fadhil-1911/temp_humi_logger/docs/images/IMG_1106.jpeg

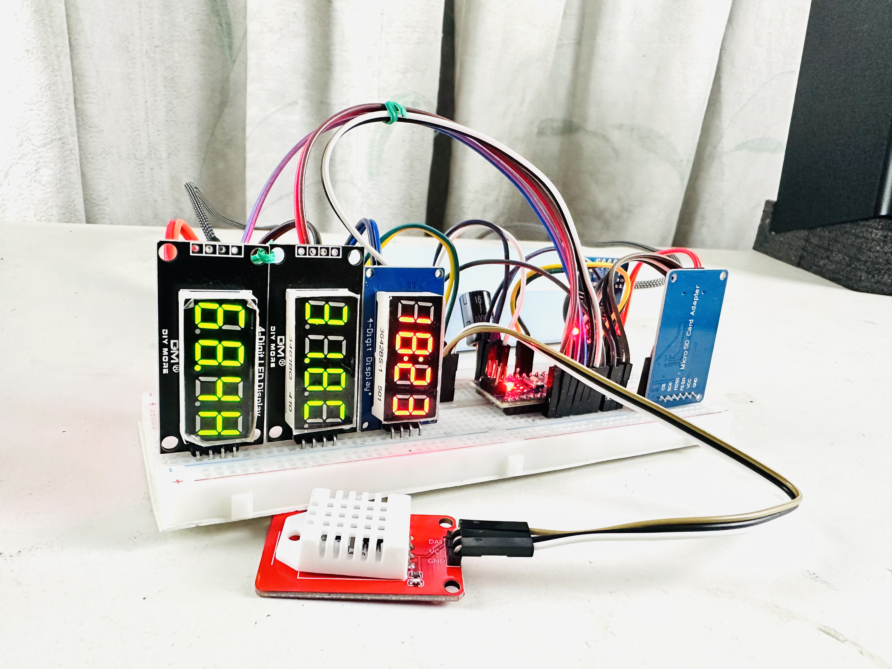
docs/images/IMG_1106.jpeg
