fadhil-1911/temp_humi_logger/docs/images/IMG_1107.jpeg

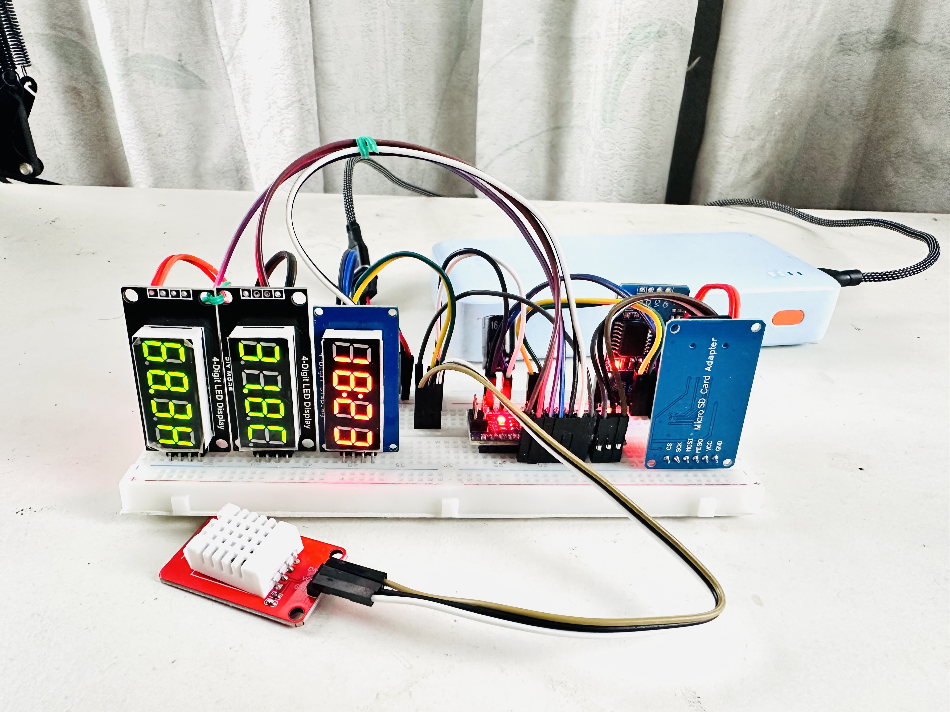
docs/images/IMG_1107.jpeg
