fadhil-1911/temp_humi_logger/docs/images/IMG_1110.jpeg

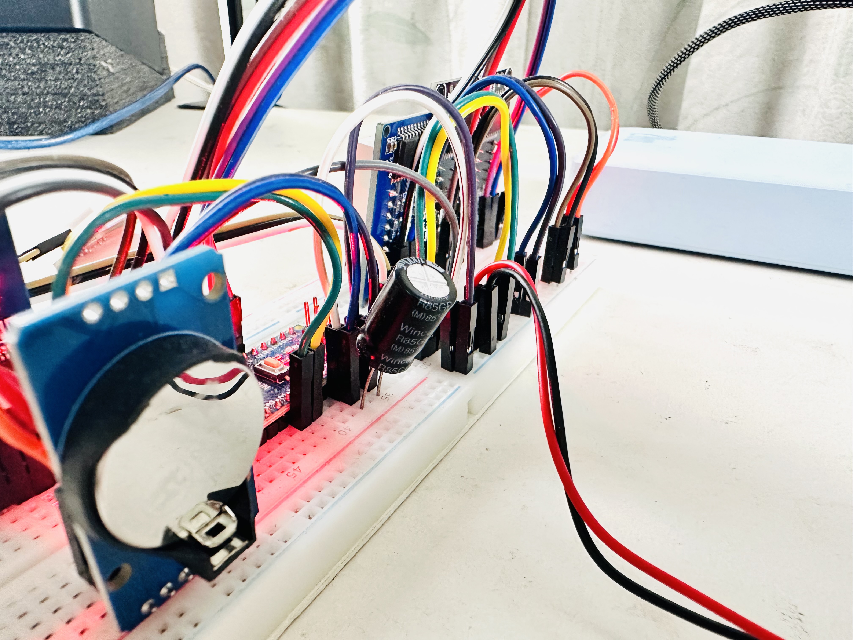
docs/images/IMG_1110.jpeg
