fadhil-1911/temp_humi_logger/docs/images/IMG_1111.jpeg

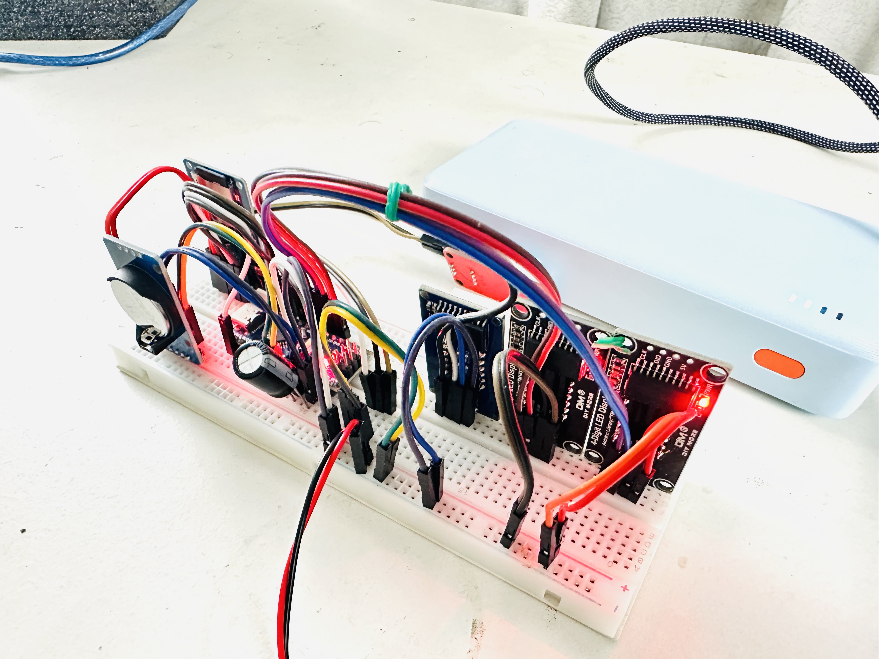
docs/images/IMG_1111.jpeg
