fadhil-1911/temp_humi_logger/docs/images/IMG_1112.jpeg

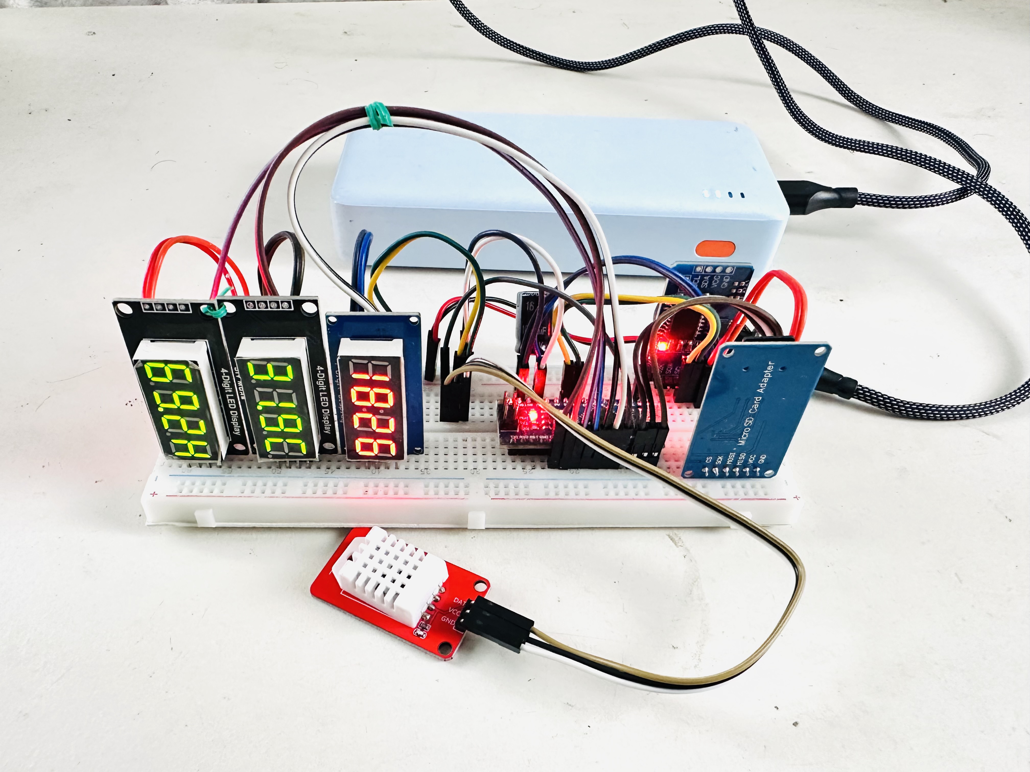
docs/images/IMG_1112.jpeg
