fadhil-1911/temp_humi_logger/temp_humi_logger.ino

//+++++++++++++++++++++++++++++++++++++++++++++++++++++++++
//                  Temp/Humi Logger
//                   Version: 1.3.0
//+++++++++++++++++++++++++++++++++++++++++++++++++++++++++
/*
  Project : Temp/Humi Logger with RTC + DHT22/SHT41 + SD + TM1637
  Version : 1.3.0
  Date    : 2026-08-26

Updates: - Added SHT41 temperature and humidity sensor support. 
- Added compile-time selection between DHT22 and SHT41. 
- Added SHT41 initialization and communication failure detection. 
- Added sensor-specific non-blocking read and retry handling.
- Added SHT41 retry with up to 3 attempts per 2-second sampling slot.. 
- Prevented failed SHT41 transactions from producing stale or invalid readings. 
- Generalized sensor status reporting using SENSOR_OK. 
- Added fail-safe SD handling so sensor, RTC, display, and heartbeat continue 
- operating after an SD logging failure. 
- SD logging is disabled after a card failure until the logger is reset. 
- Optimized constant Serial strings with F() to reduce SRAM usage. 
- Removed 8-second hardware watchdog recovery due to stability issues
*/

//==========================================================
// Libraries
//==========================================================
#include <SmartTM1637.h>  // TM1637 display control
#include <Wire.h>         // I2C communication
#include <RTClib.h>       // DS3231 RTC support
#include <SdFat.h>        // SD card file system

//==========================================================
// Pin Configuration
//==========================================================
#define HEARTBEAT_LED 9  // External heartbeat LED
#define DHT_PIN 8        // DHT22 data pin

#define CLK_PIN_1 2  // TM1637 display 1 clock pin
#define DIO_PIN_1 3  // TM1637 display 1 data pin

#define CLK_PIN_2 4  // TM1637 display 2 clock pin
#define DIO_PIN_2 5  // TM1637 display 2 data pin

#define CLK_PIN_3 6  // TM1637 display 3 clock pin
#define DIO_PIN_3 7  // TM1637 display 3 data pin

#define CS_PIN 10  // SD card SPI chip-select pin

#define VERSION "v130"  // Firmware version shown during startup


//==========================================================
// ****************** Sensor Selection *********************
//==========================================================
// Select ONE sensor only.
//
// Remove // to ENABLE the sensor.
// Add    // to DISABLE the sensor.
//
// Example:
// #define SENSOR_DHT22   -> DHT22 enabled
// //#define SENSOR_DHT22 -> DHT22 disabled
//
// IMPORTANT: Enable only ONE sensor at a time.

#define SENSOR_DHT22   // DHT22 sensor
//#define SENSOR_SHT41  // SHT41 sensor

//========================================================
#ifdef SENSOR_DHT22
#include <MyDHT22.h>
#endif

#ifdef SENSOR_SHT41
#include <Adafruit_Sensor.h>
#include <Adafruit_SHT4x.h>
#endif

//==========================================================
// Device Objects
//==========================================================
SmartTM1637 display_1(CLK_PIN_1, DIO_PIN_1);  // Temperature display
SmartTM1637 display_2(CLK_PIN_2, DIO_PIN_2);  // Humidity display
SmartTM1637 display_3(CLK_PIN_3, DIO_PIN_3);  // RTC clock display

RTC_DS3231 rtc;  // DS3231 RTC object
SdFat SD;        // SD card file-system object
File logFile;    // SD log file object


#ifdef SENSOR_DHT22
MyDHT22 dht(DHT_PIN);
#endif

#ifdef SENSOR_SHT41
Adafruit_SHT4x sht4;
#endif

//==========================================================
// SENSOR Timing
//==========================================================
unsigned long lastReadTimeSensor = 0;  // Time of the last completed SENSOR session

//==========================================================
// RTC Display Timing
//==========================================================
unsigned long lastClockUpdate = 0;              // Last clock display update time
const unsigned long clockUpdateInterval = 250;  // Update clock display every 250 ms

//==========================================================
// Heartbeat Timing
//==========================================================
unsigned long lastHeartbeat = 0;  // Last heartbeat toggle time
bool heartbeatState = false;      // Current heartbeat LED state

//==========================================================
// SENSOR Non-Blocking Retry State
//==========================================================
const unsigned long sensorInterval = 2000;  // Fixed 2-second sampling slot

#ifdef SENSOR_SHT41
const int maxRetry = 3;                   // Maximum SHT41 attempts per slot
const unsigned long retryInterval = 200;  // 200 ms between SHT41 attempts
#endif

int retryCount = 0;
unsigned long lastRetryTime = 0;

bool readOK = false;           // True when the latest SENSOR read succeeds
bool retryInProgress = false;  // True while a retry session is active
bool resultReady = false;      // True when a SENSOR session has completed

float temp = 0.0;  // Latest valid temperature value
float humi = 0.0;  // Latest valid humidity value

//==========================================================
// Device Status Flags
//==========================================================
bool sensorStatus = false;  // SENSOR read status
bool rtcStatus = false;     // RTC read status
bool sdStatus = false;      // SD card status
bool disp1Status = false;   // Temperature display status
bool disp2Status = false;   // Humidity display status

//==========================================================
// Setup
//==========================================================
void setup() {

  // Initialize serial communication for diagnostics.
  Serial.begin(9600);

  // Initialize all TM1637 displays.
  display_1.begin(4);
  display_2.begin(4);
  display_3.begin(1);

  // Initialize the I2C bus.
  Wire.begin();

  // Use standard-mode I2C for improved long-run stability.
  Wire.setClock(100000);

  // Abort and reset the TWI hardware if an I2C transaction
  // remains stuck for more than 25 ms.
  Wire.setWireTimeout(25000, true);

  // Initialize the DS3231 RTC.
  if (!rtc.begin()) {
    Serial.println("RTC initialization failed");
  }

  // Show startup information on the displays.
  display_1.print("init");
  display_2.print(VERSION, false, true, true, false);

  // Configure the external heartbeat LED.
  pinMode(HEARTBEAT_LED, OUTPUT);

  // RTC adjustment:
  // Uncomment once when the RTC must be synchronized with compile time.
  // rtc.adjust(DateTime(F(__DATE__), F(__TIME__)));

  //========================================================
  // SD Card Initialization
  //========================================================
  sdStatus = SD.begin(CS_PIN);

  if (!sdStatus) {
    Serial.println(F("❌ Failed to initialize SD card!"));
    display_1.print("SdEr");
  } else {
    Serial.println(F("✅ SD Card OK"));
  }

  //========================================================
  // Create CSV Header
  //========================================================
  // Create log.csv only when it does not already exist.
  if (sdStatus && !SD.exists("log.csv")) {
    logFile = SD.open("log.csv", FILE_WRITE);

    if (logFile) {
      logFile.println(
        "Date,Time,Temp_C,Humi_PCT,"
        "SENSOR_OK,RTC_OK,SD_OK,DISP1_OK,DISP2_OK,VCC_V");

      logFile.close();
    }
  }



#ifdef SENSOR_DHT22
  Serial.println(F("Sensor: DHT22"));
#endif

#ifdef SENSOR_SHT41
  Serial.println(F("Sensor: SHT41"));

  sensorStatus = sht4.begin();

  if (!sensorStatus) {
    Serial.println(F("SHT41 initialization failed!"));
  } else {
    Serial.println(F("SHT41 initialization OK"));
  }
#endif

  // Allow startup messages to remain visible before normal operation.
  delay(3000);
}

//==========================================================
// Main Loop
//==========================================================
void loop() {

  // Capture millis() once and reuse it throughout this loop iteration.
  unsigned long currentMillis = millis();

  //========================================================
  // 1. Start a New SENSOR Reading Session
  //========================================================
  // Begin a new session when:
  // - no retry session is active,
  // - no completed result is waiting to be processed,
  // - at least 2 seconds have passed since the previous session.
  if (!retryInProgress && !resultReady && currentMillis - lastReadTimeSensor >= sensorInterval) {

    // Record the start time of this reading session.
    lastReadTimeSensor = currentMillis;

    // Reset the retry and result states.
    retryCount = 0;
    readOK = false;
    sensorStatus = false;
    disp1Status = false;
    disp2Status = false;

    // Mark the retry state machine as active.
    retryInProgress = true;

// Backdate lastRetryTime so the first read attempt
// can execute immediately without waiting.
#ifdef SENSOR_SHT41
    lastRetryTime = currentMillis - retryInterval;
#endif
  }

  //========================================================
  // 2. Process SENSOR Reading / Retry Attempts
  //========================================================

#ifdef SENSOR_DHT22

  // DHT22 performs only ONE read attempt per 2-second sampling slot.
  if (retryInProgress) {

    if (dht.readData()) {

      temp = dht.getTemperature();
      humi = dht.getHumidity();

      if (!isnan(temp) && !isnan(humi)) {
        sensorStatus = true;
        readOK = true;
      } else {
        sensorStatus = false;
        readOK = false;
      }

    } else {

      Serial.println(F("DHT22 reading failed"));
      sensorStatus = false;
      readOK = false;
    }

    // DHT22 does not retry within the current sampling slot.
    retryInProgress = false;
    resultReady = true;
  }

#endif


#ifdef SENSOR_SHT41

  // SHT41 may perform up to three attempts within the current
  // 2-second sampling slot, with 200 ms between attempts.
  if (retryInProgress && currentMillis - lastRetryTime >= retryInterval) {

    lastRetryTime = currentMillis;

    sensors_event_t humidity, temperature;

    bool shtReadOK = sht4.getEvent(&humidity, &temperature);

    if (shtReadOK) {

      temp = temperature.temperature;
      humi = humidity.relative_humidity;

      if (!isnan(temp) && !isnan(humi)) {

        sensorStatus = true;
        readOK = true;
        retryInProgress = false;
        resultReady = true;

      } else {

        retryCount++;

        Serial.print(F("SHT41 invalid reading: "));
        Serial.print(retryCount);
        Serial.print(F("/"));
        Serial.println(maxRetry);

        if (retryCount >= maxRetry) {
          sensorStatus = false;
          readOK = false;
          retryInProgress = false;
          resultReady = true;
        }
      }

    } else {

      retryCount++;

      Serial.print(F("SHT41 communication failed: "));
      Serial.print(retryCount);
      Serial.print(F("/"));
      Serial.println(maxRetry);

      if (retryCount >= maxRetry) {
        sensorStatus = false;
        readOK = false;
        retryInProgress = false;
        resultReady = true;
      }
    }
  }

#endif


//========================================================
// 3. Process the Completed Sensor Result
//========================================================
if (resultReady) {

  // Clear the result flag so this block runs only once per session.
  resultReady = false;

  //======================================================
  // 3.1 Read RTC Timestamp
  //======================================================
  DateTime now = rtc.now();

  // Check whether the RTC transaction caused an I2C timeout.
  if (Wire.getWireTimeoutFlag()) {
    Serial.println("WARNING: I2C timeout during RTC log read");

    // Clear the timeout flag so future transactions can be monitored.
    Wire.clearWireTimeoutFlag();

    // Mark the RTC timestamp as invalid.
    rtcStatus = false;

  } else {

    // Perform a basic validity check on the RTC year.
    rtcStatus = (now.year() >= 2020);
  }

  // Allocate fixed-size buffers for CSV date and time strings.
  char dateStr[11];
  char timeStr[9];

  // Format the RTC date as YYYY-MM-DD.
  snprintf(
    dateStr,
    sizeof(dateStr),
    "%04d-%02d-%02d",
    now.year(),
    now.month(),
    now.day());

  // Format the RTC time as HH:MM:SS.
  snprintf(
    timeStr,
    sizeof(timeStr),
    "%02d:%02d:%02d",
    now.hour(),
    now.minute(),
    now.second());

  //======================================================
  // 3.2 Measure MCU Supply Voltage
  //======================================================
  // Read VCC only once and reuse the same value
  // for Serial output and SD logging.
  long vccMillivolts = readVcc();
  float vccVolts = vccMillivolts / 1000.0;

  // Warn when the measured 5 V rail drops below 4.5 V.
  if (vccVolts < 4.5) {
    Serial.println(F("WARNING: Low VCC"));
  }

  //======================================================
  // 3.3 Update Temperature and Humidity Displays
  //======================================================
  if (readOK) {

    // Display the latest valid temperature and humidity values.
    display_1.print(temp, "C", true);
    display_2.print(humi, "h", true);

    // Mark both sensor displays as successfully updated.
    disp1Status = true;
    disp2Status = true;

    // Print the current measurement to Serial Monitor.
    Serial.print(F("Temp: "));
    Serial.print(temp, 1);
    Serial.print(F(" | Humidity: "));
    Serial.print(humi, 1);
    Serial.print(F(" | VCC: "));
    Serial.print(vccVolts, 2);
    Serial.println(F(" V"));

  } else {

    // Show an error message when all SENSOR attempts fail.
    display_1.print("Err");
    display_2.print("Err");

    // Mark both sensor displays as invalid for this cycle.
    disp1Status = false;
    disp2Status = false;

    Serial.println(F("❌ Sensor reading failed for this sampling slot"));
  }

  //======================================================
  // 3.4 Open CSV Log File
  //======================================================
  if (sdStatus) {

    logFile = SD.open("log.csv", FILE_WRITE);

    if (logFile) {

      sdStatus = true;

      // Date
      if (rtcStatus) {
        logFile.print(dateStr);
      } else {
        logFile.print("NA");
      }

      logFile.print(",");

      // Time
      if (rtcStatus) {
        logFile.print(timeStr);
      } else {
        logFile.print("NA");
      }

      logFile.print(",");

      // Temperature
      if (sensorStatus) {
        logFile.print(temp, 1);
      } else {
        logFile.print("NA");
      }

      logFile.print(",");

      // Humidity
      if (sensorStatus) {
        logFile.print(humi, 1);
      } else {
        logFile.print("NA");
      }

      // Device Status Flags
      logFile.print(",");
      logFile.print(sensorStatus ? "1" : "0");

      logFile.print(",");
      logFile.print(rtcStatus ? "1" : "0");

      logFile.print(",");
      logFile.print(sdStatus ? "1" : "0");

      logFile.print(",");
      logFile.print(disp1Status ? "1" : "0");

      logFile.print(",");
      logFile.print(disp2Status ? "1" : "0");

      // VCC
      logFile.print(",");
      logFile.println(vccVolts, 2);

      logFile.close();

      if (sensorStatus && rtcStatus) {
        Serial.println(F("✅ Log saved to SD card"));

      } else if (!sensorStatus && !rtcStatus) {
        Serial.println(F("⚠️ SENSOR and RTC failure logged"));

      } else if (!sensorStatus) {
        Serial.println(F("⚠️ SENSOR failure logged"));

      } else {
        Serial.println(F("⚠️ RTC failure logged"));
      }

    } else {

      sdStatus = false;
      Serial.println(F("❌ Failed to open log.csv"));
      Serial.println(F("⚠️ SD Card Not Available - RESET required"));
    }
  }
}

//========================================================
// 4. Update the RTC Clock Display
//========================================================
// Update the clock display every 250 ms instead of reading
// the RTC continuously on every loop iteration.
if (currentMillis - lastClockUpdate >= clockUpdateInterval) {

  // Record the time of this display update.
  lastClockUpdate = currentMillis;

  // Read the current RTC time.
  DateTime clockNow = rtc.now();

  // Check whether the RTC read caused an I2C timeout.
  if (Wire.getWireTimeoutFlag()) {
    Serial.println(F("WARNING: I2C timeout"));

    // Clear the timeout flag for future monitoring.
    Wire.clearWireTimeoutFlag();

    // Mark the RTC as unavailable.
    rtcStatus = false;

  } else {

    // RTC communication succeeded.
    rtcStatus = true;

    // Extract hour and minute for the clock display.
    uint8_t hour = clockNow.hour();
    uint8_t minute = clockNow.minute();

    // Blink the clock colon every 500 ms.
    bool showColon = (currentMillis / 500) % 2 == 0;

    // Update the TM1637 clock display.
    display_3.printTime(
      hour,
      minute,
      showColon);
  }
}

//========================================================
// 5. Main Loop Heartbeat
//========================================================
// Toggle the external LED every second.
// A stopped LED indicates that the main loop is no longer progressing.
if (currentMillis - lastHeartbeat >= 1000) {

  // Save the current heartbeat timestamp.
  lastHeartbeat = currentMillis;

  // Toggle the LED state.
  heartbeatState = !heartbeatState;

  // Apply the new state to the external LED.
  digitalWrite(HEARTBEAT_LED, heartbeatState);
}
}

//==========================================================
// Internal VCC Monitor
//==========================================================
long readVcc() {

  // Select AVcc as the ADC reference and measure
  // the ATmega328P internal nominal 1.1 V reference.
  ADMUX = _BV(REFS0) | _BV(MUX3) | _BV(MUX2) | _BV(MUX1);

  // Allow the ADC reference and multiplexer to stabilize.
  delay(2);

  // Perform one dummy conversion to stabilize the ADC result.
  ADCSRA |= _BV(ADSC);

  while (bit_is_set(ADCSRA, ADSC)) {
  }

  // Perform the actual ADC conversion.
  ADCSRA |= _BV(ADSC);

  while (bit_is_set(ADCSRA, ADSC)) {
  }

  // Read the completed ADC conversion result.
  uint16_t result = ADC;

  // Avoid division by zero if the ADC returns an invalid result.
  if (result == 0) {
    return 0;
  }

  // Calibrated internal-reference constant used to estimate VCC.
  const long VCC_CALIBRATION = 1111800L;

  // Return the estimated MCU supply voltage in millivolts.
  return VCC_CALIBRATION / result;
}

//========================= END =========================
