fadhil-1911/temp_humi_logger/(commit log)

2026-08-05 Enhance DHT22 reading with non-blocking retries
    Added logic to handle up to three non-blocking retry attempts for DHT22 readings, improving reliability of temperature and humidity data collection.
2026-08-05 Create wiring
2026-08-05 Create arduino_nano_wiring_diagram
2026-08-05 Create arduino_nano
2026-08-06 Add wiring diagram section to README
    Added wiring diagram for Arduino Nano setup.
2026-08-06 Update wiring diagram image in README
2026-08-06 Create flowcharts
2026-08-06 Revise DHT22 loop operation flow documentation
    This update enhances the DHT22 loop operation flow documentation by providing a comprehensive overview of the non-blocking reading, retry, display, RTC, voltage monitoring, and SD-card logging processes.
2026-08-13 fix: improve logger reliability and freeze handling
    - Move heartbeat LED from D13 to D9 to avoid SPI SCK conflict
    - Reduce I2C clock from 400 kHz to 100 kHz
    - Add Wire timeout handling and automatic TWI reset
    - Limit RTC display updates to reduce I2C traffic
    - Detect RTC timeout during logging
    - Log NA for invalid RTC date/time
    - Make heartbeat independent from DHT22 read status
    - Fix function/bracket structure around readVcc()
    [temp_humi_logger.ino]
2026-08-14 fix: improve long-run reliability with watchdog and voltage monitoring
    - Add 8-second hardware watchdog recovery
    - Add periodic wdt_reset() in main loop
    - Keep I2C timeout protection and 100 kHz bus speed
    - Keep RTC polling interval to reduce I2C traffic
    - Move heartbeat LED to D9
    - Add low-VCC warning below 4.5 V
    - Log NA when RTC timestamp is invalid
    - Keep RTC and DHT failure status logging
    - Remove unstable MCUSR reset-cause startup handling
    [temp_humi_logger.ino]
2026-08-14 Update README for version 1.2.3 changesu
    Version 1.2.3 focuses on long-run reliability, adding hardware watchdog recovery, I2C timeout protection, independent heartbeat monitoring, low-voltage diagnostics, and improved RTC handling.
2026-08-26 Update README for version 1.3.0 enhancements
    Updated README for version 1.3.0, adding SHT41 support and improving sensor handling.
2026-08-26 Add operational flowchart for Temp/Humi Logger
    Document the operational flowchart for Temp/Humi Logger v1.3.0, detailing components, connections, and processes.
2026-08-26 Add flowchart documentation for Temp/Humi Logger
    Document the flowchart for the Temp/Humi Logger v1.3.0, detailing the system architecture, components, and their interactions.
2026-08-26 update - Removed 8-second hardware watchdog recovery due to stability issues
    [temp_humi_logger.ino]
2026-08-26 Revert to 29fad0d (1.1.3)
    [temp_humi_logger.ino]
2026-08-26 Update flowcharts for v1.3.0
2026-08-26 Fix flowchart links in README
2026-08-27 Change wiring diagram image for Arduino Nano
    Updated wiring diagram image reference in README.
2026-08-27 Fix image filename in README for wiring diagram
2026-08-27 Fix image filename in README wiring diagram
2026-08-27 Revise README for sensor retry and sampling updates
    Updated README to reflect changes in sensor retry mechanism and sampling cycle. Improved clarity on SHT41 integration and reliability features.
2026-08-28 Upload arduino nano datasheet
